TsunaHalo2001/RECUV/src/Conexiones/Conectores circulares RECUV 2/4 pines blank.jpg

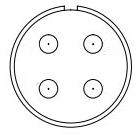
src/Conexiones/Conectores circulares RECUV 2/4 pines blank.jpg
