TsunaHalo2001/RECUV/RECUV PCB/REV 0.1/RECUV01/Schematic.pdf

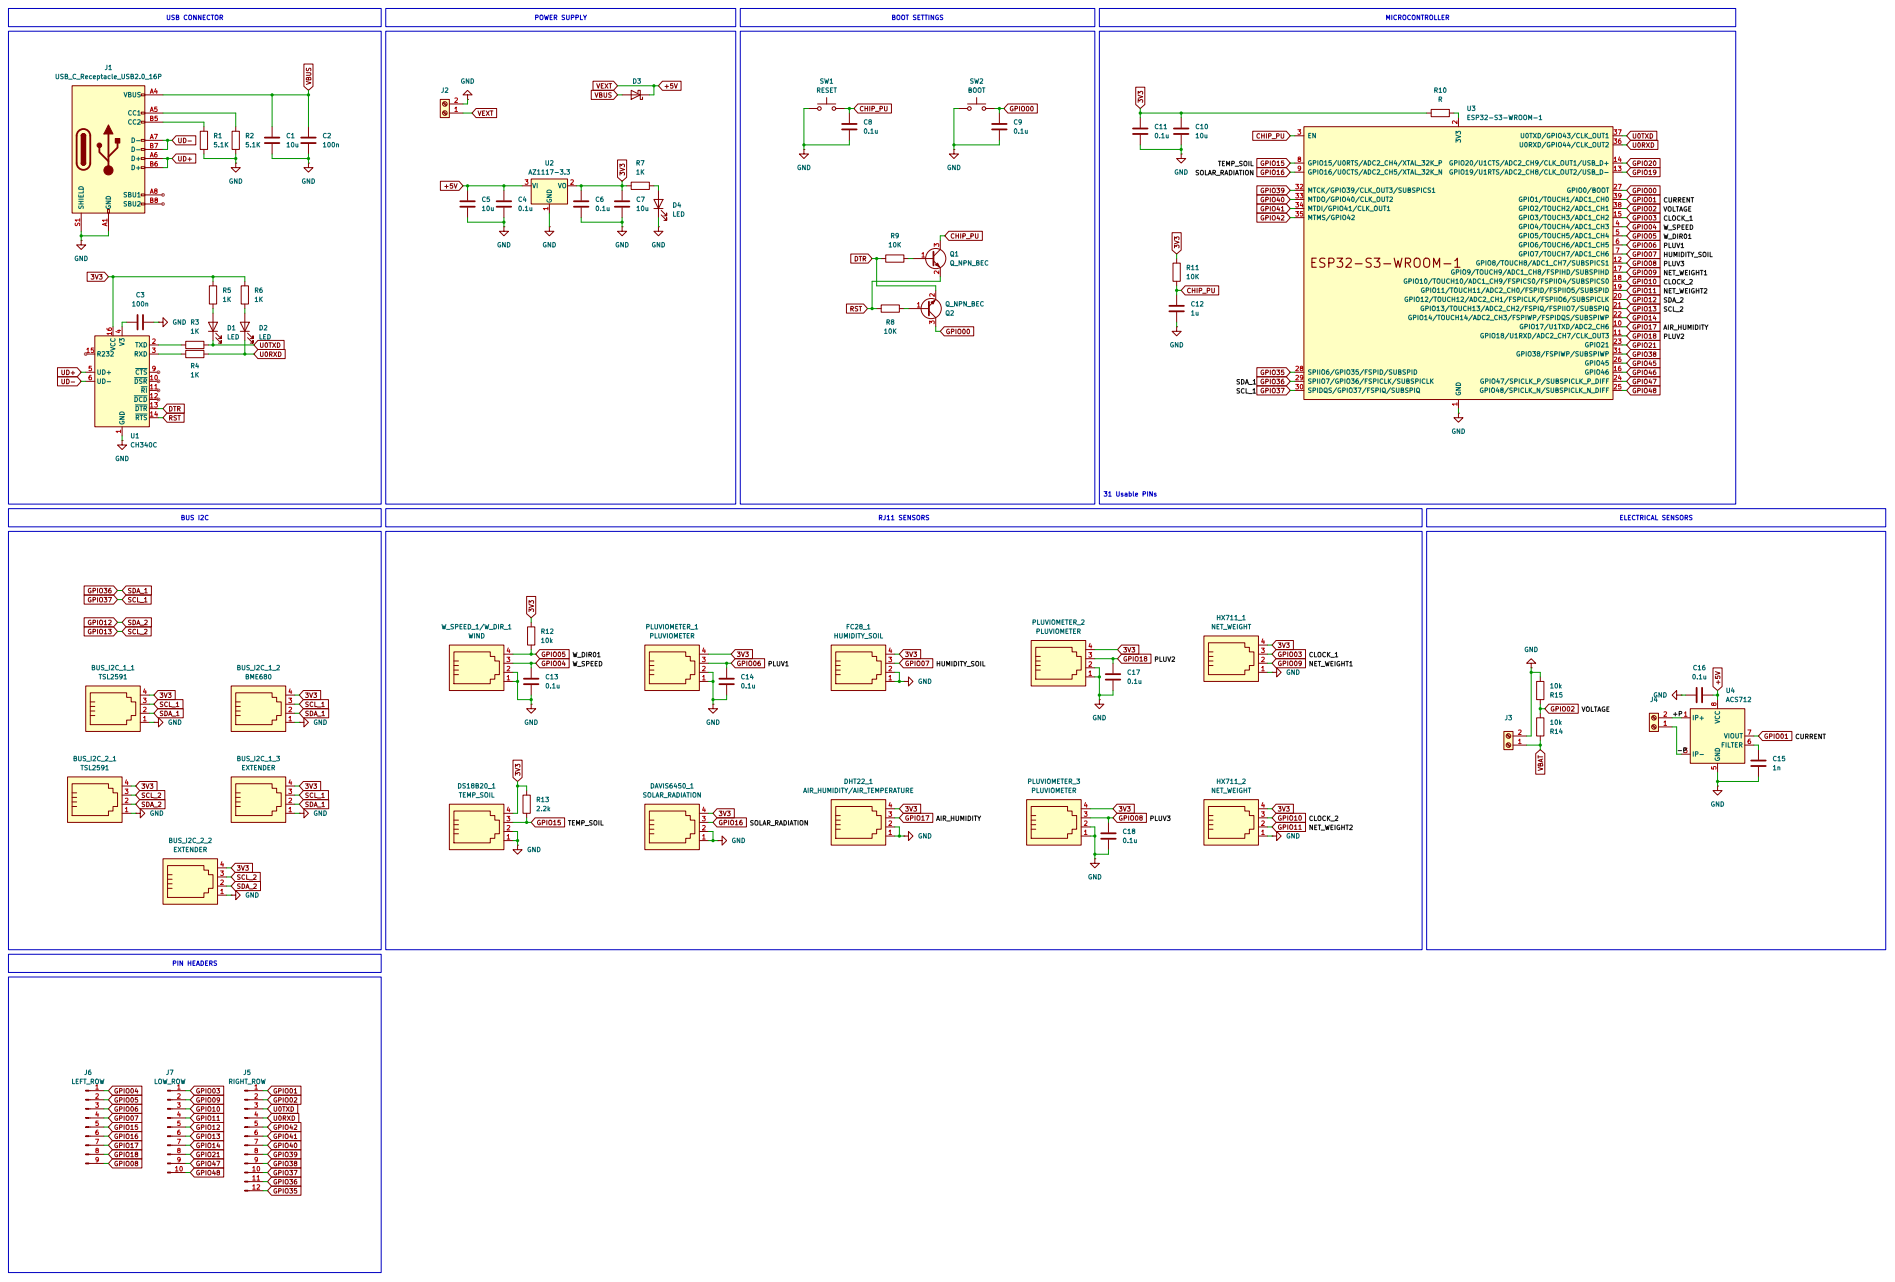
[picture p4: page 1]
