TsunaHalo2001/RECUV/RECUV PCB/REV 0.1/RECUV02_old/RECUV02.kicad_pcb

## KiCad design RECUV PCB/REV 0.1/RECUV02_old/RECUV02.kicad_pcb (2026-07-24, an earlier design)

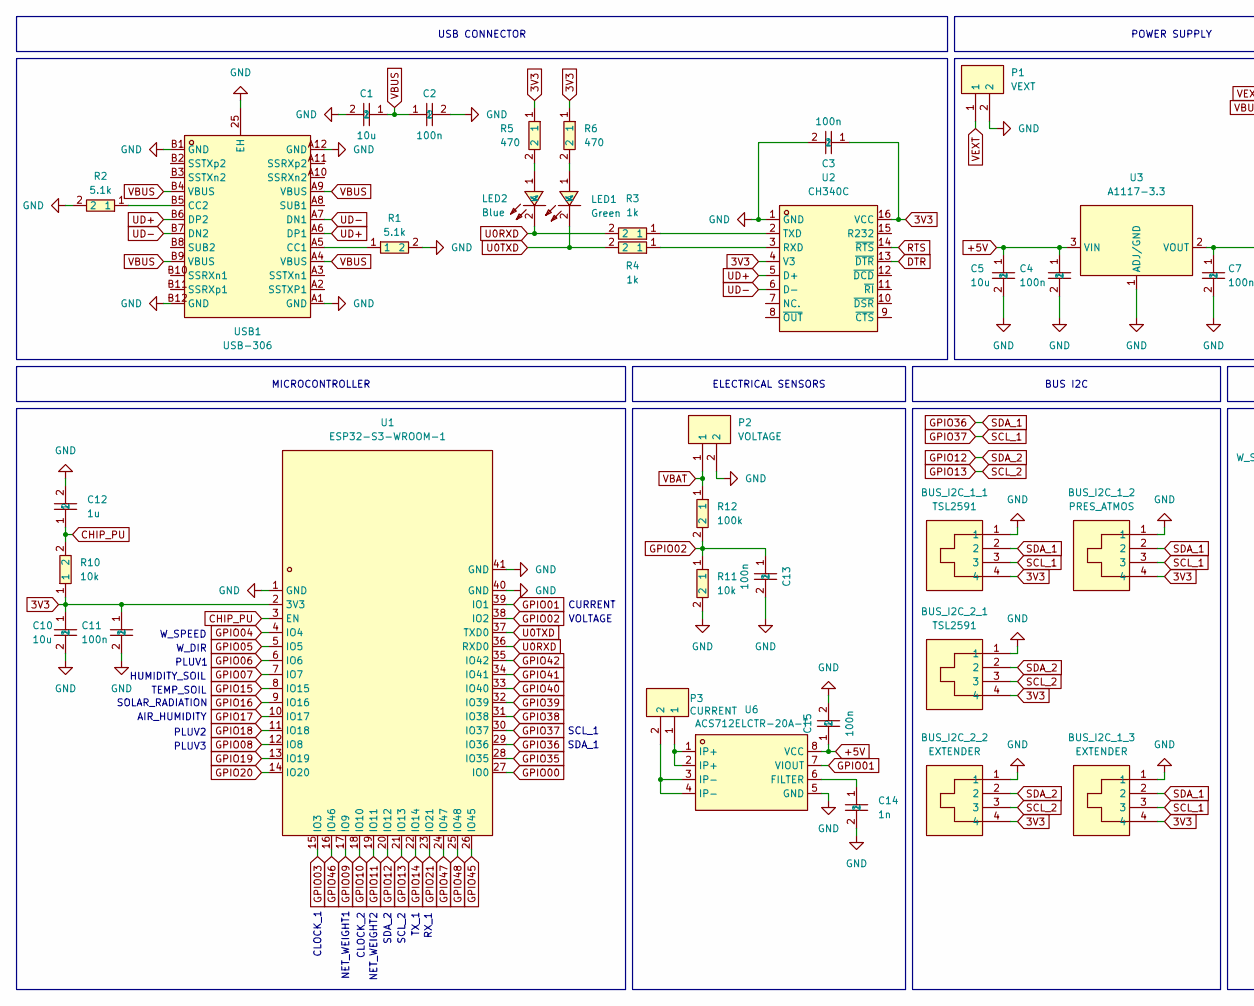
[picture p5: schematic RECUV02.kicad_sch, part in row 1, column 1]

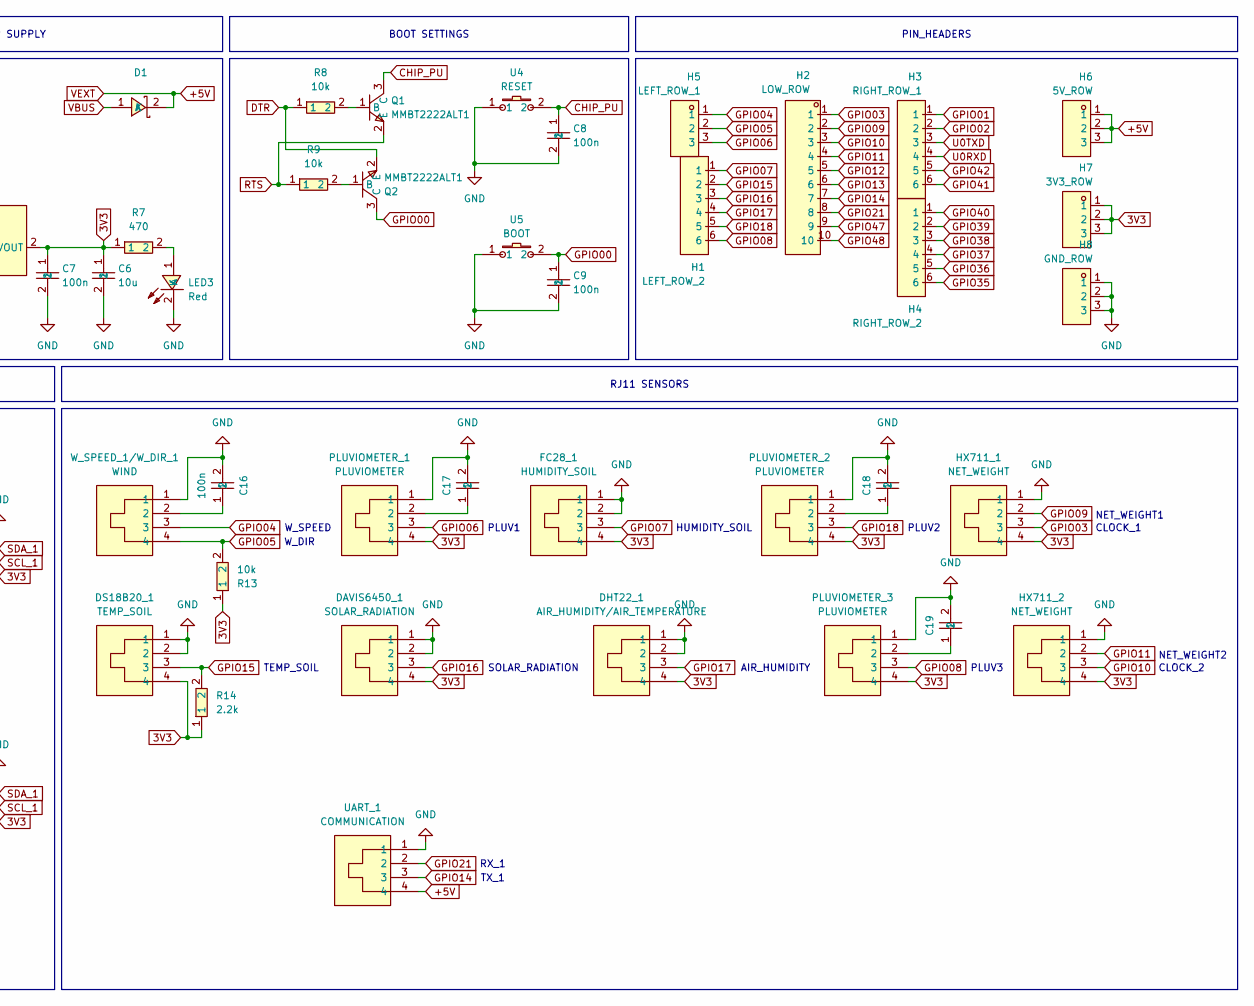
[picture p6: schematic RECUV02.kicad_sch, part in row 1, column 2]

Parts:
BUS_I2C_1_1, BUS_I2C_2_1: TSL2591; RJ11-TH_PCB-6P4C-90; MPN R-RJ11R04P-A800; LCSC Part C189749
BUS_I2C_1_2: PRES_ATMOS; RJ11-TH_PCB-6P4C-90; MPN R-RJ11R04P-A800; LCSC Part C189749
BUS_I2C_1_3, BUS_I2C_2_2: EXTENDER; RJ11-TH_PCB-6P4C-90; MPN R-RJ11R04P-A800; LCSC Part C189749
C1, C5, C6, C10: 10u; C0805; MPN CL21A106KOQNNNE; LCSC Part C1713
C2, C3, C4, C7, C8, C9, C11, C13, C15, C16, C17, C18, C19: 100n; C0805; MPN CL21B104KBCNNNC; LCSC Part C1711
C12: 1u; C0805; MPN CL21B105KAFNFNE; LCSC Part C1712
C14: 1n; C0805; MPN CL21C102JBCNNNC; LCSC Part C1791
D1: SS54_C22452; SMA_L4.4-W2.8-LS5.4-R-RD; MPN SS54; LCSC Part C22452
DAVIS6450_1: SOLAR_RADIATION; RJ11-TH_PCB-6P4C-90; MPN R-RJ11R04P-A800; LCSC Part C189749
DHT22_1: AIR_HUMIDITY/AIR_TEMPERATURE; RJ11-TH_PCB-6P4C-90; MPN R-RJ11R04P-A800; LCSC Part C189749
DS18B20_1: TEMP_SOIL; RJ11-TH_PCB-6P4C-90; MPN R-RJ11R04P-A800; LCSC Part C189749
FC28_1: HUMIDITY_SOIL; RJ11-TH_PCB-6P4C-90; MPN R-RJ11R04P-A800; LCSC Part C189749
H1: LEFT_ROW_2; HDR-TH_6P-P2.54-V-M-1; MPN 2.54-1x6P直针; LCSC Part C37208
H2: LOW_ROW; HDR-TH_10P-P2.54-V-M-1; MPN 2.54-1*10P针; LCSC Part C57369
H3: RIGHT_ROW_1; HDR-TH_6P-P2.54-V-M-1; MPN 2.54-1x6P直针; LCSC Part C37208
H4: RIGHT_ROW_2; HDR-TH_6P-P2.54-V-M-1; MPN 2.54-1x6P直针; LCSC Part C37208
H5: LEFT_ROW_1; HDR-TH_3P-P2.54-V-M; MPN A2541WV-3P; LCSC Part C5445396
H6: 5V_ROW; HDR-TH_3P-P2.54-V-M; MPN A2541WV-3P; LCSC Part C5445396
H7: 3V3_ROW; HDR-TH_3P-P2.54-V-M; MPN A2541WV-3P; LCSC Part C5445396
H8: GND_ROW; HDR-TH_3P-P2.54-V-M; MPN A2541WV-3P; LCSC Part C5445396
HX711_1, HX711_2: NET_WEIGHT; RJ11-TH_PCB-6P4C-90; MPN R-RJ11R04P-A800; LCSC Part C189749
LED1: Green; LED0805-R-RD; MPN KT-0805G; LCSC Part C2297
LED2: Blue; LED0805-R-RD; MPN KT-0805B; LCSC Part C2293
LED3: Red; LED0805-R-RD; MPN KT-0805R; LCSC Part C2295
P1: VEXT; CONN-TH_2P-P5.00_CPC3703CTR; MPN WJ127-5.0-02P-14-00A; LCSC Part C3703
P2: VOLTAGE; CONN-TH_2P-P5.00_CPC3703CTR; MPN WJ127-5.0-02P-14-00A; LCSC Part C3703
P3: CURRENT; CONN-TH_2P-P5.00_CPC3703CTR; MPN WJ127-5.0-02P-14-00A; LCSC Part C3703
PLUVIOMETER_1, PLUVIOMETER_2, PLUVIOMETER_3: PLUVIOMETER; RJ11-TH_PCB-6P4C-90; MPN R-RJ11R04P-A800; LCSC Part C189749
Q1, Q2: MMBT2222ALT1; SOT-23-3_L3.0-W1.7-P0.95-LS2.9-BR; MPN MMBT2222ALT1; LCSC Part C402270
R1, R2: 5.1k; R0805; MPN 0805W8J0512T5E; LCSC Part C26023
R3, R4: 1k; R0805; MPN 0805W8F1001T5E; LCSC Part C17513
R5, R6, R7: 470; R0805; MPN 0805W8F4700T5E; LCSC Part C17710
R8, R9, R10, R11, R13: 10k; R0805; MPN 0805W8F1002T5E; LCSC Part C17414
R12: 100k; R0805; MPN 0805W8J0104T5E; LCSC Part C25611
R14: 2.2k; R0603; MPN 0603WAF2201T5E; LCSC Part C4190
U1: ESP32-S3-WROOM-1; WIRELM-SMD_ESP32-S3-WROOM-1; MPN ESP32-S3-WROOM-1-N16R8; LCSC Part C2913202
U2: CH340C; SOP-16_L10.0-W3.9-P1.27-LS6.0-BL; MPN CH340C; LCSC Part C84681
U3: A1117-3.3; SOT-223-3_L6.5-W3.4-P2.30-LS7.0-BR-1; MPN A1117-3.3; LCSC Part C7432020
U4: RESET; SW-SMD_KSR213GLFG; MPN KSR213GLFG; LCSC Part C668561
U5: BOOT; SW-SMD_KSR213GLFG; MPN KSR213GLFG; LCSC Part C668561
U6: ACS712ELCTR-20A-T; SOIC-8_L4.9-W3.9-P1.27-LS6.0-BL; MPN ACS712ELCTR-20A-T; LCSC Part C10681
UART_1: COMMUNICATION; RJ11-TH_PCB-6P4C-90; MPN R-RJ11R04P-A800; LCSC Part C189749
USB1: USB-306; USB-TYPE-C-TH_USB-306-1; MPN USB-306-B-SU; LCSC Part C309338
W_SPEED_1/W_DIR_1: WIND; RJ11-TH_PCB-6P4C-90; MPN R-RJ11R04P-A800; LCSC Part C189749

Connections:
3V3: BUS_I2C_1_1.4, BUS_I2C_1_2.4, BUS_I2C_1_3.4, BUS_I2C_2_1.4, BUS_I2C_2_2.4, C3.1, C6.1, C7.1, C10.1, C11.1, DAVIS6450_1.4, DHT22_1.4, DS18B20_1.4, FC28_1.4, H7.1, H7.2, H7.3, HX711_1.4, HX711_2.4, PLUVIOMETER_1.4, PLUVIOMETER_2.4, PLUVIOMETER_3.4, R5.1, R6.1, R7.1, R10.1, R13.1, R14.1, U1.2 (3V3), U2.4 (V3), U2.16 (VCC), U3.2 (VOUT)
+5V: C4.1, C5.1, C15.1, D1.2 (K), H6.1, H6.2, H6.3, P1.1, U3.3 (VIN), U6.8 (VCC), UART_1.4
CHIP_PU: C8.1, C12.1, Q1.3 (C), R10.2, U1.3 (EN), U4.2
DTR: Q2.2 (E), R8.1, U2.13 (~DTR)
GND: BUS_I2C_1_1.1, BUS_I2C_1_2.1, BUS_I2C_1_3.1, BUS_I2C_2_1.1, BUS_I2C_2_2.1, C1.2, C2.2, C3.2, C4.2, C5.2, C6.2, C7.2, C8.2, C9.2, C10.2, C11.2, C12.2, C13.2, C14.2, C15.2, C16.2, C17.2, C18.2, C19.2, DAVIS6450_1.1, DAVIS6450_1.2, DHT22_1.1, DHT22_1.2, DS18B20_1.1, DS18B20_1.2, FC28_1.1, FC28_1.2, H8.1, H8.2, H8.3, HX711_1.1, HX711_2.1, LED3.2 (K), P1.2, P2.2, PLUVIOMETER_1.1, PLUVIOMETER_2.1, PLUVIOMETER_3.1, R1.2, R2.2, R11.2, U1.1 (GND), U1.40 (GND), U1.41 (GND), U2.1 (GND), U3.1 (ADJ/GND), U4.1, U5.1, U6.5 (GND), UART_1.1, USB1.25 (EH), USB1.A1 (GND), USB1.A12 (GND), USB1.B1 (GND), USB1.B12 (GND), W_SPEED_1/W_DIR_1.1
GPIO00: C9.1, Q2.3 (C), U1.27 (IO0), U5.2
GPIO01: H3.1, U1.39 (IO1), U6.7 (VIOUT)
GPIO02: C13.1, H3.2, R11.1, R12.2, U1.38 (IO2)
GPIO03: H2.1, HX711_1.3, U1.15 (IO3)
GPIO04: H5.1, U1.4 (IO4), W_SPEED_1/W_DIR_1.3
GPIO05: H5.2, R13.2, U1.5 (IO5), W_SPEED_1/W_DIR_1.4
GPIO06: H5.3, PLUVIOMETER_1.3, U1.6 (IO6)
GPIO07: FC28_1.3, H1.1, U1.7 (IO7)
GPIO08: H1.6, PLUVIOMETER_3.3, U1.12 (IO8)
GPIO09: H2.2, HX711_1.2, U1.17 (IO9)
GPIO10: H2.3, HX711_2.3, U1.18 (IO10)
GPIO11: H2.4, HX711_2.2, U1.19 (IO11)
GPIO12: BUS_I2C_2_1.2, BUS_I2C_2_2.2, H2.5, U1.20 (IO12)
GPIO13: BUS_I2C_2_1.3, BUS_I2C_2_2.3, H2.6, U1.21 (IO13)
GPIO14: H2.7, U1.22 (IO14), UART_1.3
GPIO15: DS18B20_1.3, H1.2, R14.2, U1.8 (IO15)
GPIO16: DAVIS6450_1.3, H1.3, U1.9 (IO16)
GPIO17: DHT22_1.3, H1.4, U1.10 (IO17)
GPIO18: H1.5, PLUVIOMETER_2.3, U1.11 (IO18)
GPIO19: U1.13 (IO19)
GPIO20: U1.14 (IO20)
GPIO21: H2.8, U1.23 (IO21), UART_1.2
GPIO35: H4.6, U1.28 (IO35)
GPIO36: BUS_I2C_1_1.2, BUS_I2C_1_2.2, BUS_I2C_1_3.2, H4.5, U1.29 (IO36)
GPIO37: BUS_I2C_1_1.3, BUS_I2C_1_2.3, BUS_I2C_1_3.3, H4.4, U1.30 (IO37)
GPIO38: H4.3, U1.31 (IO38)
GPIO39: H4.2, U1.32 (IO39)
GPIO40: H4.1, U1.33 (IO40)
GPIO41: H3.6, U1.34 (IO41)
GPIO42: H3.5, U1.35 (IO42)
GPIO45: U1.26 (IO45)
GPIO46: U1.16 (IO46)
GPIO47: H2.9, U1.24 (IO47)
GPIO48: H2.10, U1.25 (IO48)
unnamed: C16.1, W_SPEED_1/W_DIR_1.2
unnamed: C17.1, PLUVIOMETER_1.2
unnamed: C18.1, PLUVIOMETER_2.2
unnamed: C19.1, PLUVIOMETER_3.2
unnamed: LED1.1 (A), R6.2
unnamed: LED2.1 (A), R5.2
unnamed: LED3.1 (A), R7.2
unnamed: P3.1, U6.1 (IP+), U6.2 (IP+)
unnamed: P3.2, U6.3 (IP-), U6.4 (IP-)
unnamed: Q1.1 (B), R8.2
unnamed: Q2.1 (B), R9.2
unnamed: R4.1, U2.3 (RXD)
unnamed: R3.1, U2.2 (TXD)
unnamed: C14.1, U6.6 (FILTER)
unnamed: R1.1, USB1.A5 (CC1)
unnamed: R2.1, USB1.B5 (CC2)
RTS: Q1.2 (E), R9.1, U2.14 (~RTS)
U0RXD: H3.4, LED2.2 (K), R3.2, U1.36 (RXD0)
U0TXD: H3.3, LED1.2 (K), R4.2, U1.37 (TXD0)
UD+: U2.5 (D+), USB1.A6 (DP1), USB1.B6 (DP2)
UD-: U2.6 (D-), USB1.A7 (DN1), USB1.B7 (DN2)
VBAT: P2.1, R12.1
VBUS: C1.1, C2.1, D1.1 (A), USB1.A4 (VBUS), USB1.A9 (VBUS), USB1.B4 (VBUS), USB1.B9 (VBUS)

Notes on the sheet:
PLUV1
RX_1
HUMIDITY_SOIL
CURRENT
CLOCK_2
TX_1
SCL_1
W_SPEED
NET_WEIGHT2
NET_WEIGHT1
CLOCK_1
SDA_1
W_DIR
PLUV2
VOLTAGE
SOLAR_RADIATION
TEMP_SOIL
PLUV3
AIR_HUMIDITY
SCL_2
SDA_2
PIN_HEADERS
USB CONNECTOR
MICROCONTROLLER
RJ11 SENSORS
POWER SUPPLY
BUS I2C
BOOT SETTINGS
ELECTRICAL SENSORS

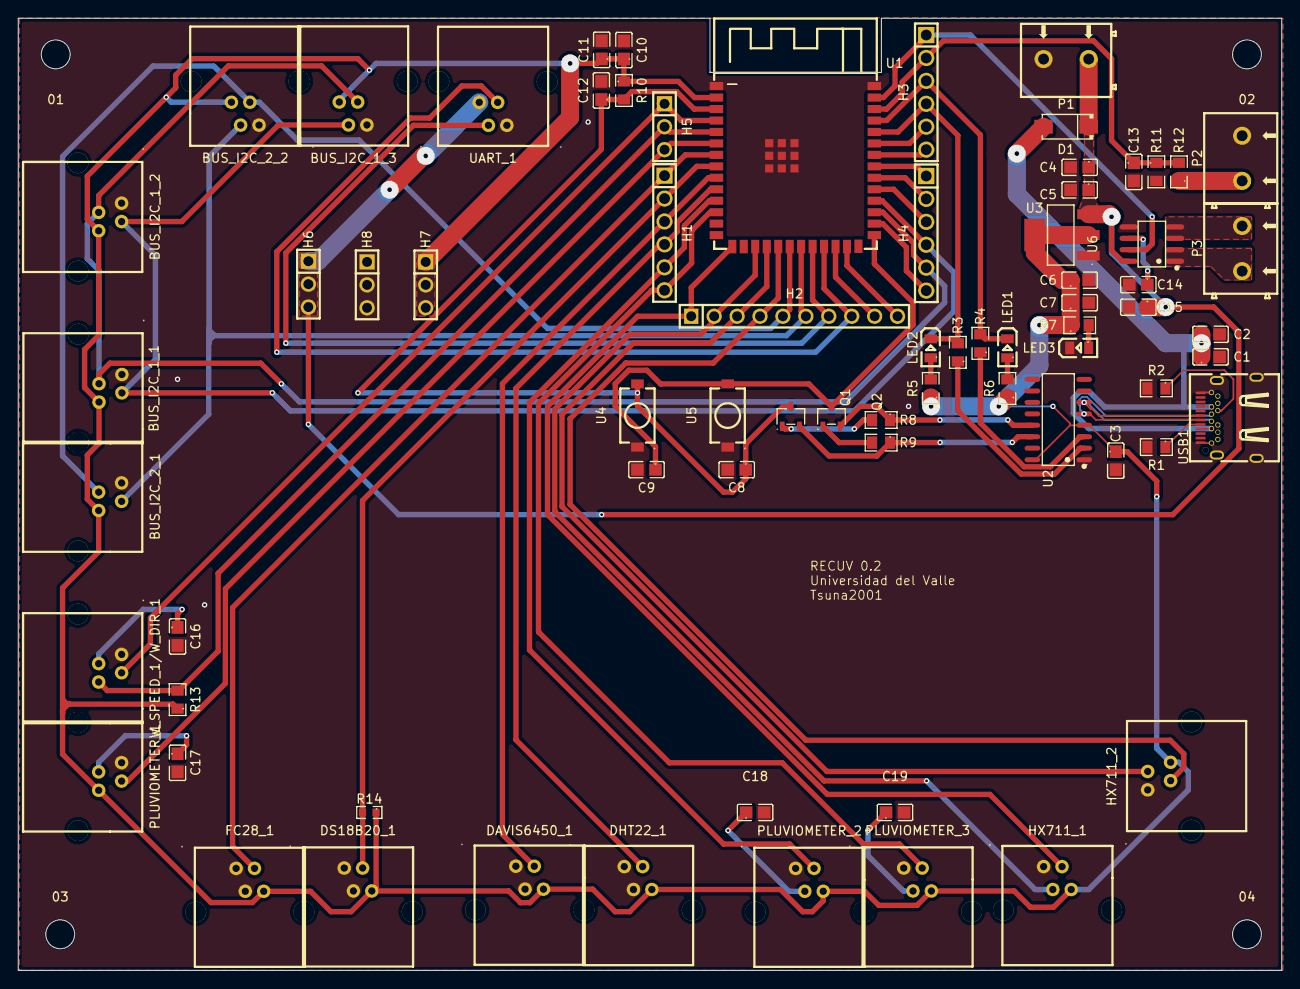
[picture p7: board RECUV02.kicad_pcb from above]

Board: 2 copper layers, 140.0 x 105.5 mm, 77 parts (0 on the bottom side), 58 nets.

Other parts of the board:
01, 02, 03, 04: MountingHole_3.2mm_M3
