TsunaHalo2001/RECUV/RECUV PCB/REV 0.1/RECUV01/RECUV01.kicad_pcb

## KiCad design RECUV PCB/REV 0.1/RECUV01/RECUV01.kicad_pcb (2025-07-10)

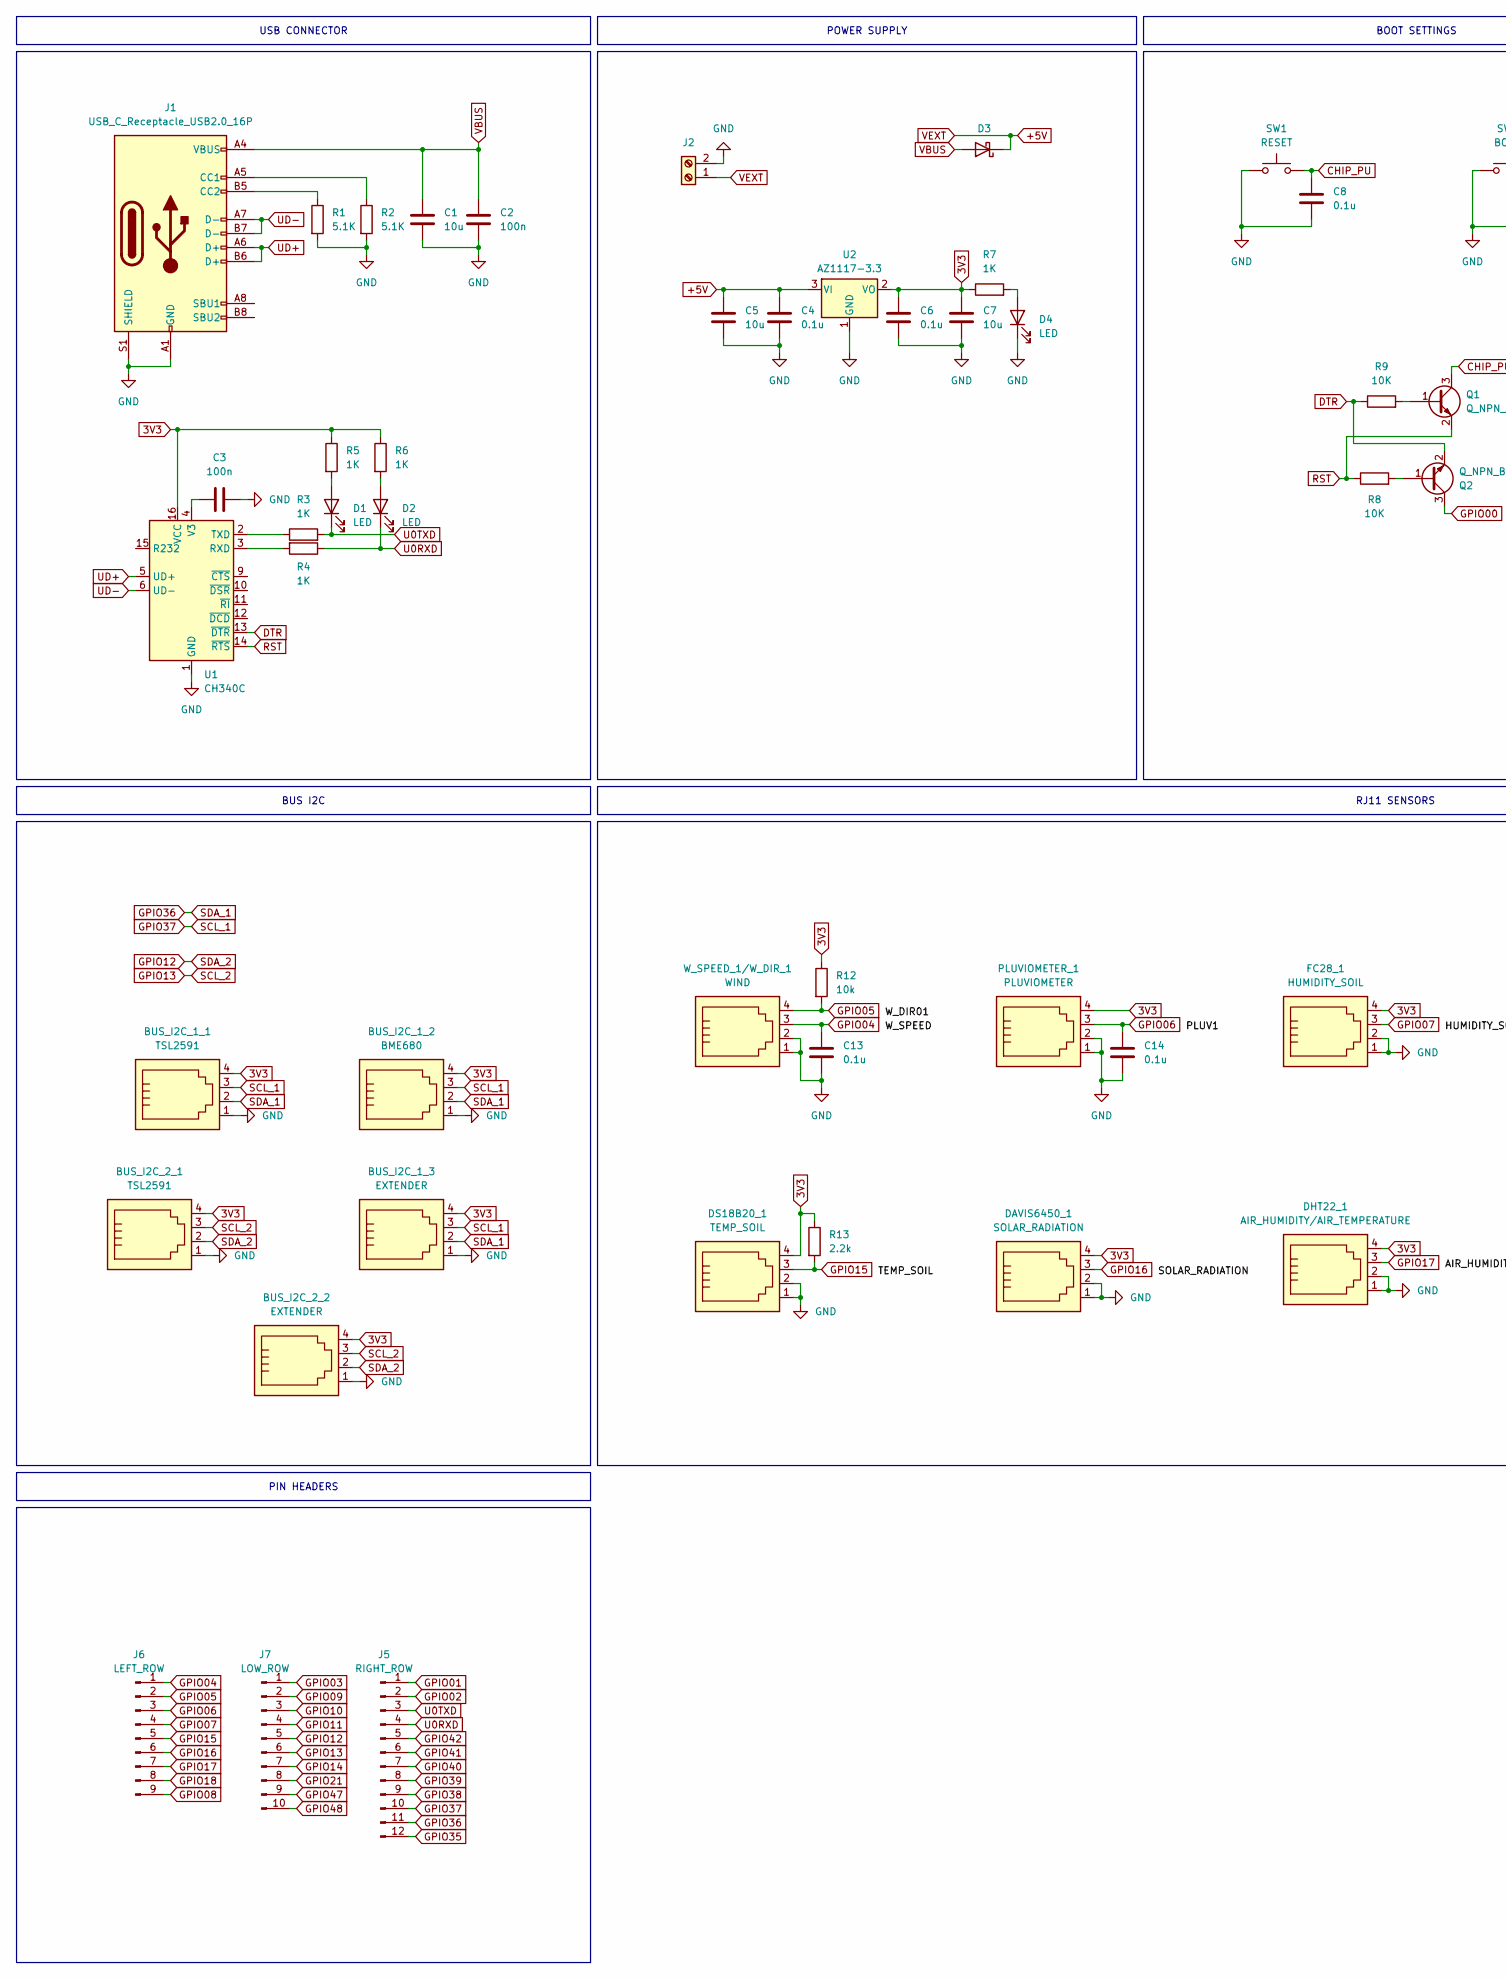
[picture p8: schematic RECUV01.kicad_sch, part in row 1, column 1]

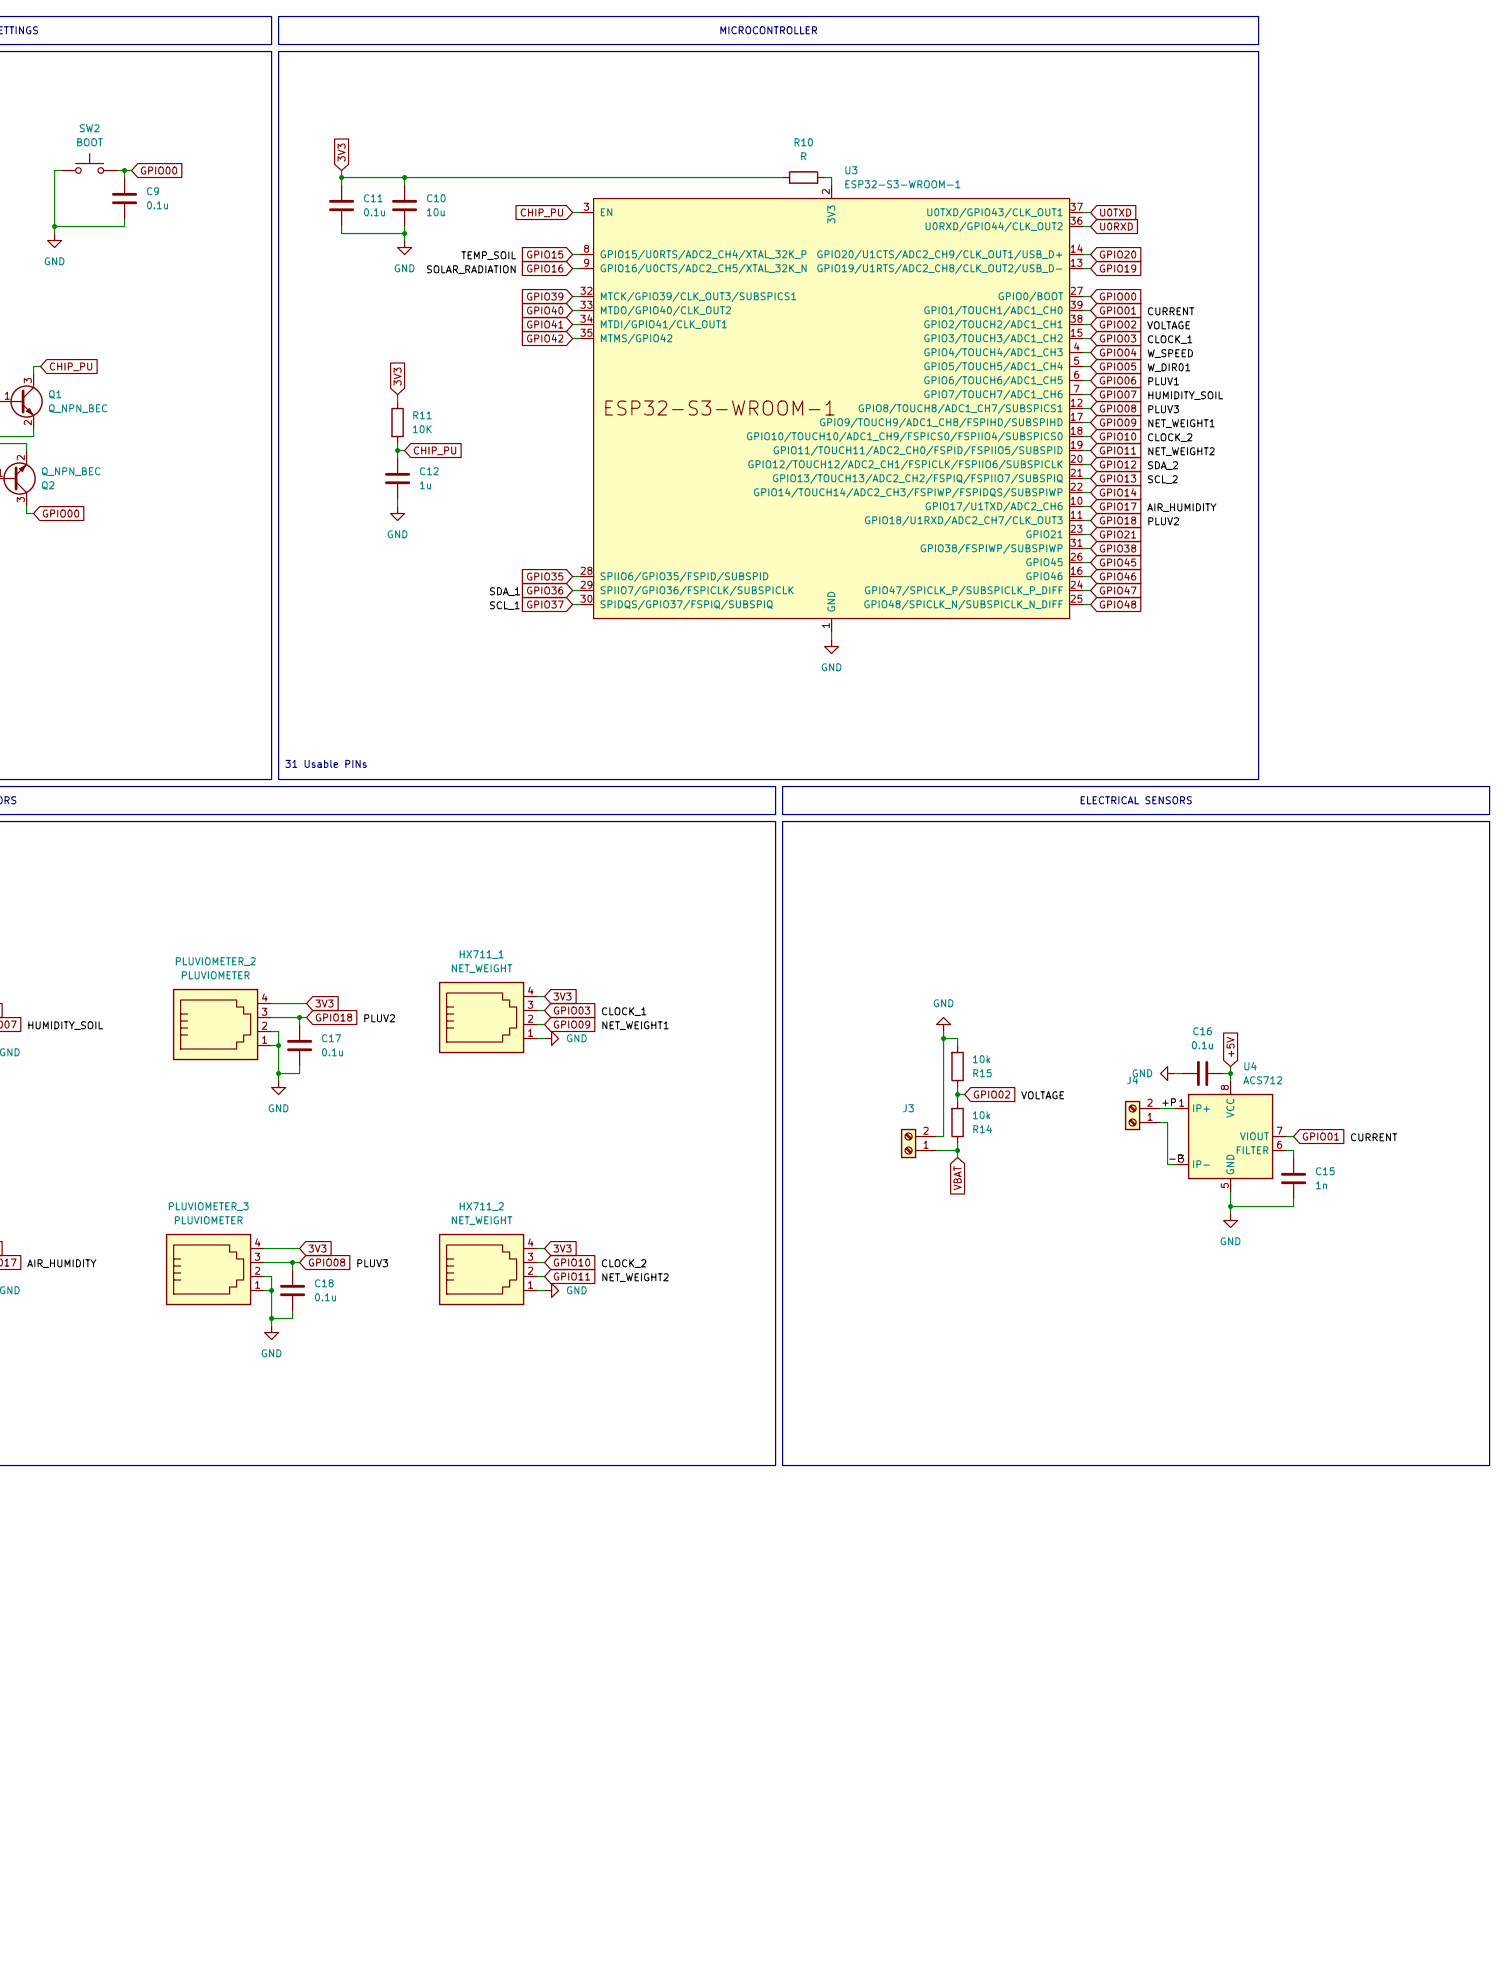
[picture p9: schematic RECUV01.kicad_sch, part in row 1, column 2]

Parts:
BUS_I2C_1_1, BUS_I2C_2_1: TSL2591; RJ9_Evercom_5301-440xxx_Horizontal
BUS_I2C_1_2: BME680; RJ9_Evercom_5301-440xxx_Horizontal
BUS_I2C_1_3, BUS_I2C_2_2: EXTENDER; RJ9_Evercom_5301-440xxx_Horizontal
C1, C5, C7, C10: 10u; C_0805_2012Metric
C2, C3: 100n; C_0805_2012Metric
C4, C6, C8, C9, C11, C13, C14, C16, C17, C18: 0.1u; C_0805_2012Metric
C12: 1u; C_0805_2012Metric
C15: 1n; C_0805_2012Metric
D1, D2, D4: LED; LED_0805_2012Metric
D3: D_Schottky; D_SMA
DAVIS6450_1: SOLAR_RADIATION; RJ9_Evercom_5301-440xxx_Horizontal
DHT22_1: AIR_HUMIDITY/AIR_TEMPERATURE; RJ9_Evercom_5301-440xxx_Horizontal
DS18B20_1: TEMP_SOIL; RJ9_Evercom_5301-440xxx_Horizontal
FC28_1: HUMIDITY_SOIL; RJ9_Evercom_5301-440xxx_Horizontal
HX711_1, HX711_2: NET_WEIGHT; RJ9_Evercom_5301-440xxx_Horizontal
J1: USB_C_Receptacle_USB2.0_16P; USB_C_Receptacle_XKB_U262-16XN-4BVC11
J2: Screw_Terminal_01x02; TerminalBlock_Altech_AK300-2_P5.00mm
J3, J4: TerminalBlock_Altech_AK300-2_P5.00mm
J5: RIGHT_ROW; PinHeader_1x12_P2.54mm_Vertical
J6: LEFT_ROW; PinHeader_1x09_P2.54mm_Vertical
J7: LOW_ROW; PinHeader_1x10_P2.54mm_Vertical
PLUVIOMETER_1, PLUVIOMETER_2, PLUVIOMETER_3: PLUVIOMETER; RJ9_Evercom_5301-440xxx_Horizontal
Q1, Q2: Q_NPN_BEC; SOT-23-3
R1, R2: 5.1K; R_0805_2012Metric
R3, R4, R5, R6, R7: 1K; R_0805_2012Metric
R8, R9, R11: 10K; R_0805_2012Metric
R10: R; R_0805_2012Metric
R12, R14, R15: 10k; R_0805_2012Metric
R13: 2.2k; R_0805_2012Metric
SW1: RESET; SW_Tactile_SPST_NO_Straight_CK_PTS636Sx25SMTRLFS
SW2: BOOT; SW_Tactile_SPST_NO_Straight_CK_PTS636Sx25SMTRLFS
U1: CH340C; SOIC-16_3.9x9.9mm_P1.27mm
U2: AZ1117-3.3; SOT-223-3_TabPin2
U3: ESP32-S3-WROOM-1
U4: ACS712; SOIC-8_3.9x4.9mm_P1.27mm
W_SPEED_1/W_DIR_1: WIND; RJ9_Evercom_5301-440xxx_Horizontal

Connections:
3V3: BUS_I2C_1_1.4, BUS_I2C_1_2.4, BUS_I2C_1_3.4, BUS_I2C_2_1.4, BUS_I2C_2_2.4, C6.1, C7.1, C10.1, C11.1, DAVIS6450_1.4, DHT22_1.4, DS18B20_1.4, FC28_1.4, HX711_1.4, HX711_2.4, PLUVIOMETER_1.4, PLUVIOMETER_2.4, PLUVIOMETER_3.4, R5.1, R6.1, R7.1, R10.1, R11.1, R12.1, R13.1, U1.16 (VCC), U2.2 (VO)
+5V: C4.1, C5.1, C16.2, D3.1 (K), J2.1, U2.3 (VI), U4.8 (VCC)
/+P: J4.2, U4.1 (IP+), U4.2 (IP+)
/-P: J4.1, U4.3 (IP-), U4.4 (IP-)
CHIP_PU: C8.1, C12.1, Q1.3 (C), R11.2, SW1.2, U3.3 (EN)
DTR: Q2.2 (E), R9.1, U1.13 (~DTR)
GND: BUS_I2C_1_1.1, BUS_I2C_1_2.1, BUS_I2C_1_3.1, BUS_I2C_2_1.1, BUS_I2C_2_2.1, C1.2, C2.2, C3.2, C4.2, C5.2, C6.2, C7.2, C8.2, C9.2, C10.2, C11.2, C12.2, C13.2, C14.2, C15.2, C16.1, C17.2, C18.2, D4.1 (K), DAVIS6450_1.1, DAVIS6450_1.2, DHT22_1.1, DHT22_1.2, DS18B20_1.1, DS18B20_1.2, FC28_1.1, FC28_1.2, HX711_1.1, HX711_2.1, J1.A1 (GND), J1.A12 (GND), J1.B1 (GND), J1.B12 (GND), J1.S1 (SHIELD), J2.2, J3.2, PLUVIOMETER_1.1, PLUVIOMETER_1.2, PLUVIOMETER_2.1, PLUVIOMETER_2.2, PLUVIOMETER_3.1, PLUVIOMETER_3.2, R1.2, R2.2, R15.2, SW1.1, SW2.1, U1.1 (GND), U2.1 (GND), U3.1 (GND), U3.40 (GND), U3.41 (GND), U4.5 (GND), W_SPEED_1/W_DIR_1.1, W_SPEED_1/W_DIR_1.2
GPIO00: C9.1, Q2.3 (C), SW2.2, U3.27 (GPIO0/BOOT)
GPIO01: J5.1, U3.39 (GPIO1/TOUCH1/ADC1_CH0), U4.7 (VIOUT)
GPIO02: J5.2, R14.2, R15.1, U3.38 (GPIO2/TOUCH2/ADC1_CH1)
GPIO03: HX711_1.3, J7.1, U3.15 (GPIO3/TOUCH3/ADC1_CH2)
GPIO04: C13.1, J6.1, U3.4 (GPIO4/TOUCH4/ADC1_CH3), W_SPEED_1/W_DIR_1.3
GPIO05: J6.2, R12.2, U3.5 (GPIO5/TOUCH5/ADC1_CH4), W_SPEED_1/W_DIR_1.4
GPIO06: C14.1, J6.3, PLUVIOMETER_1.3, U3.6 (GPIO6/TOUCH6/ADC1_CH5)
GPIO07: FC28_1.3, J6.4, U3.7 (GPIO7/TOUCH7/ADC1_CH6)
GPIO08: C18.1, J6.9, PLUVIOMETER_3.3, U3.12 (GPIO8/TOUCH8/ADC1_CH7/SUBSPICS1)
GPIO09: HX711_1.2, J7.2, U3.17 (GPIO9/TOUCH9/ADC1_CH8/FSPIHD/SUBSPIHD)
GPIO10: HX711_2.3, J7.3, U3.18 (GPIO10/TOUCH10/ADC1_CH9/FSPICS0/FSPIIO4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)
GPIO11: HX711_2.2, J7.4, U3.19 (GPIO11/TOUCH11/ADC2_CH0/FSPID/FSPIIO5/S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)
GPIO12: BUS_I2C_2_1.2, BUS_I2C_2_2.2, J7.5, U3.20 (GPIO12/TOUCH12/ADC2_CH1/FSPICLK/FSPIIO6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)
GPIO13: BUS_I2C_2_1.3, BUS_I2C_2_2.3, J7.6, U3.21 (GPIO13/TOUCH13/ADC2_CH2/FSPIQ/FSPIIO7/S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)
GPIO14: J7.7, U3.22 (GPIO14/TOUCH14/ADC2_CH3/FSPIWP/FSPIDQS/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)
GPIO15: DS18B20_1.3, J6.5, R13.2, U3.8 (GPIO15/U0RTS/ADC2_CH4/XTAL_32K_P)
GPIO16: DAVIS6450_1.3, J6.6, U3.9 (GPIO16/U0CTS/ADC2_CH5/XTAL_32K_N)
GPIO17: DHT22_1.3, J6.7, U3.10 (GPIO17/U1TXD/ADC2_CH6)
GPIO18: C17.1, J6.8, PLUVIOMETER_2.3, U3.11 (GPIO18/U1RXD/ADC2_CH7/CLK_OUT3)
GPIO19: U3.13 (GPIO19/U1RTS/ADC2_CH8/CLK_OUT2/USB_D-)
GPIO20: U3.14 (GPIO20/U1CTS/ADC2_CH9/CLK_OUT1/USB_D+)
GPIO21: J7.8, U3.23 (GPIO21)
GPIO35: J5.12, U3.28 (SPIIO6/GPIO35/FSPID/SUBSPID)
GPIO36: BUS_I2C_1_1.2, BUS_I2C_1_2.2, BUS_I2C_1_3.2, J5.11, U3.29 (SPIIO7/GPIO36/FSPICLK/SUBSPICLK)
GPIO37: BUS_I2C_1_1.3, BUS_I2C_1_2.3, BUS_I2C_1_3.3, J5.10, U3.30 (SPIDQS/GPIO37/FSPIQ/SUBSPIQ)
GPIO38: J5.9, U3.31 (GPIO38/FSPIWP/SUBSPIWP)
GPIO39: J5.8, U3.32 (MTCK/GPIO39/CLK_OUT3/SUBSPICS1)
GPIO40: J5.7, U3.33 (MTDO/GPIO40/CLK_OUT2)
GPIO41: J5.6, U3.34 (MTDI/GPIO41/CLK_OUT1)
GPIO42: J5.5, U3.35 (MTMS/GPIO42)
GPIO45: U3.26 (GPIO45)
GPIO46: U3.16 (GPIO46)
GPIO47: J7.9, U3.24 (GPIO47/SPICLK_P/SUBSPICLK_P_DIFF)
GPIO48: J7.10, U3.25 (GPIO48/SPICLK_N/SUBSPICLK_N_DIFF)
unnamed: D1.2 (A), R5.2
unnamed: D2.2 (A), R6.2
unnamed: D4.2 (A), R7.2
unnamed: J1.A5 (CC1), R2.1
unnamed: J1.B5 (CC2), R1.1
unnamed: Q1.1 (B), R9.2
unnamed: Q2.1 (B), R8.2
unnamed: R4.2, U1.3 (RXD)
unnamed: R3.1, U1.2 (TXD)
unnamed: C3.1, U1.4 (V3)
unnamed: R10.2, U3.2 (3V3)
unnamed: C15.1, U4.6 (FILTER)
RST: Q1.2 (E), R8.1, U1.14 (~RTS)
U0RXD: D2.1 (K), J5.4, R4.1, U3.36 (U0RXD/GPIO44/CLK_OUT2)
U0TXD: D1.1 (K), J5.3, R3.2, U3.37 (U0TXD/GPIO43/CLK_OUT1)
UD+: J1.A6 (D+), J1.B6 (D+), U1.5 (UD+)
UD-: J1.A7 (D-), J1.B7 (D-), U1.6 (UD-)
VBAT: J3.1, R14.1
VBUS: C1.1, C2.1, D3.2 (A), J1.A4 (VBUS), J1.A9 (VBUS), J1.B4 (VBUS), J1.B9 (VBUS)

Notes on the sheet:
BOOT SETTINGS
USB CONNECTOR
RJ11 SENSORS
ELECTRICAL SENSORS
PIN HEADERS
BUS I2C
MICROCONTROLLER
POWER SUPPLY
31 Usable PINs

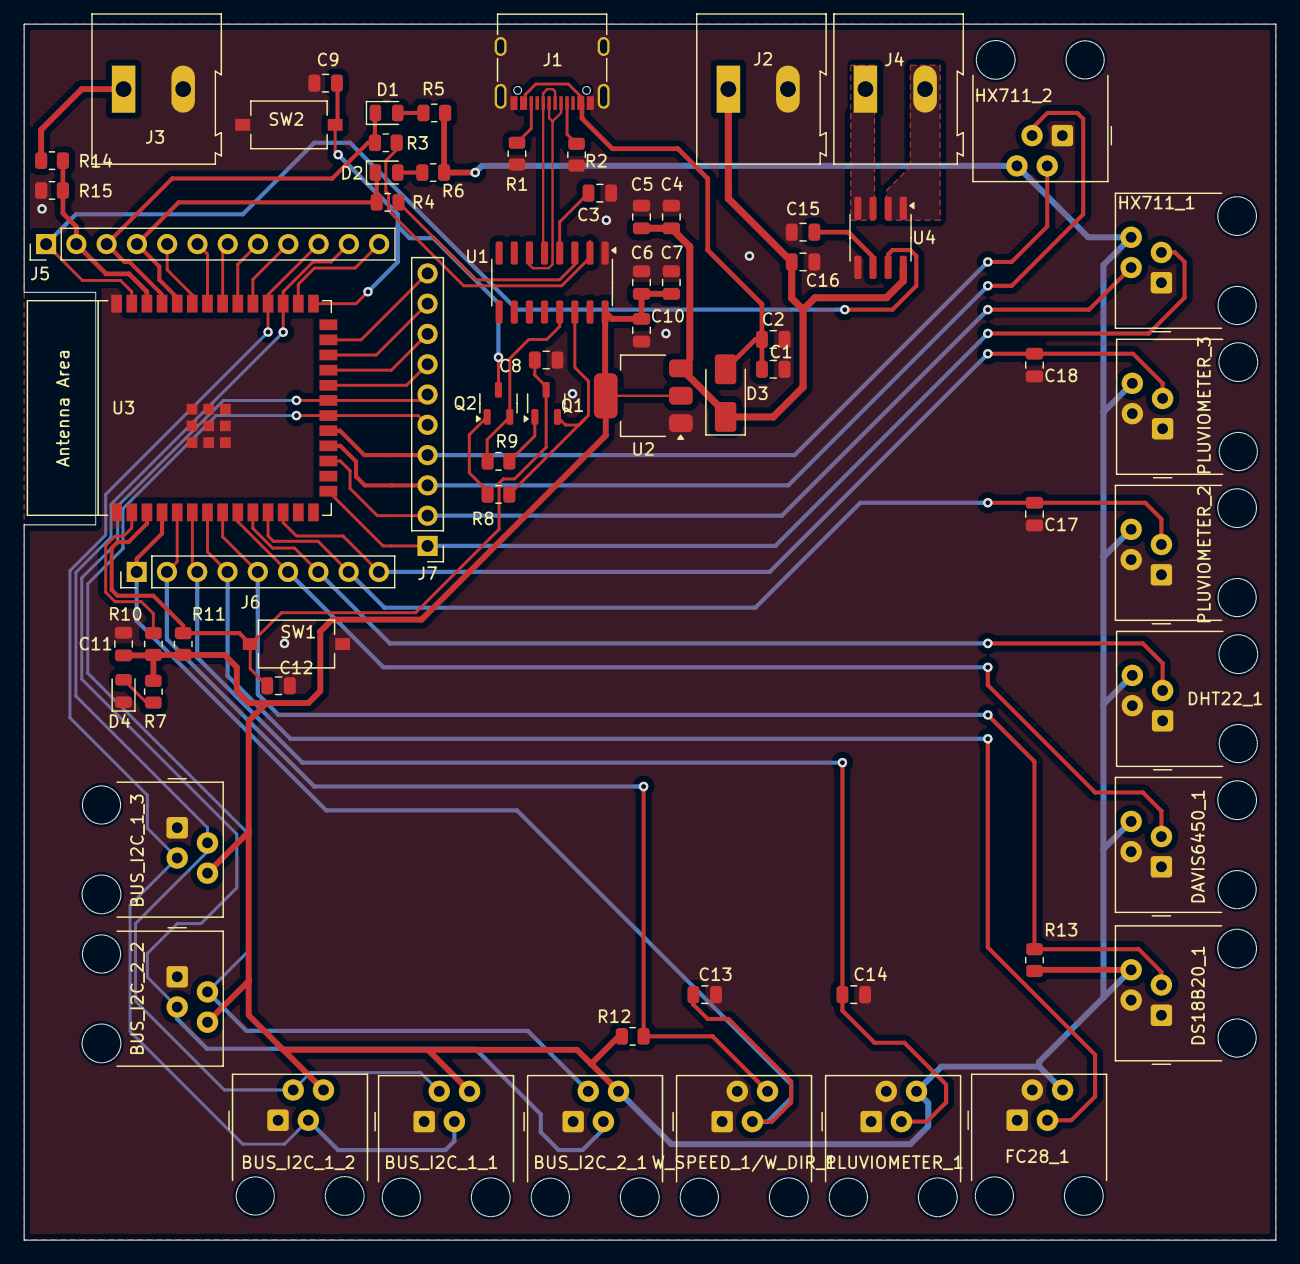
[picture p10: board RECUV01.kicad_pcb from above]

Board: 2 copper layers, 105.0 x 102.0 mm, 67 parts (0 on the bottom side), 56 nets.
