TsunaHalo2001/RECUV/RECUV 1/ESP32/main.py

# Escribe tu código aquí :-)
from system_communication import *
from machine import Pin, UART, SPI, reset, deepsleep, WDT
import json
from time import *
import network
import ntptime

wdt = WDT(timeout=60000)

import urequests as requests
import ujson

TIAMPO_SONDEO_CONST = 10*60   # CANT_MINUTOS  * 60 SEG

global CONNECTION_MODE, SSID, PASSWORD
global modemwifi


CONNECTION_MODE  = "WIFI"
#CONNECTION_MODE = "GPRS"

#SSID     = "univalle"
#PASSWORD = "Univalle"

SSID     = "GISMODEL"
PASSWORD = "GISMODEL2023"

ntptime.host = "pool.ntp.org"
ntptime.timeout = 5


global tramaRx, sensor_amb_values, gprs, modemwifi, bandera_muestreo
global textoCompuerta,textoLamina, textoMuestreo, textoHora, t_envio, contador_envio
global banderaConsumo, banderaNivel, banderaAmb
global consumoIF, nivelIF, ambIF
global tiempoSONDEOWEB
global trama



textoCompuerta =" "
textoLamina    =" "
textoMuestreo  =" "
textoHora      =" "


uart = UART(1, 9600)

#------------------------------------------------------------------#
#                        VARIABLES DE CONSUMO                      #
#------------------------------------------------------------------#

#CREAMOS UN DICCIONARIO DONDE GUARDAREMOS LAS VARIABLES DE CONSUMO

sensor_consumo_values={
"tiempo_ele":"2022-05-25 19:00:00",
"vdc_bat_comp1":"26.8",
"idc_bat_comp1":"5.5",
"cbat_comp1":"80",
"idc_siscomp1":"3.4",
"valcon_siscomp1":"52",
}


#------------------------------------------------------------------#
#                        VARIABLES DE NIVEL                        #
#------------------------------------------------------------------#

#CREAMOS UN DICCIONARIO DONDE GUARDAREMOS LAS VARIABLES DE NIVEL

sensor_nivel_values={
    "tiempo_la":"2022-05-25 19:00:00",
    "niv_lamagua":"600",
    "niv_compadm":"150",
    "niv_compsal":"40",
    "detec_amax_comp1":"False",
    "detec_ctol_comp1":"True",
    "detec_amax_comp2":"False",
    "detec_ctol_comp2":"True",
    "pos_comp1":"800",
    "pos_comp2":"650",
    "niv_compadm_ext":"270",
    "niv_compadm_cau":"400",
    "niv_compsal_cau":"250"
}

#------------------------------------------------------------------#
#                        VARIABLES AMBIENTALES                     #
#------------------------------------------------------------------#

#CREAMOS UN DICCIONARIO DONDE GUARDAREMOS LAS VARIABLES AMBIENTALES
sensor_amb_values={
    "tiempo_amb":"2022-05-25 19:00:00",
    "precipitacion":"30",
    "rad_solar":"35",
    "hum_aire":"40",
    "temp_aire":"45",
    "vel_viento":"50",
    "pres_atm":"55",
    "temp_suelo":"60",
    "hum_suelo":"65"
}

def interpreta_trama(tramaRx):
    global gprs, bandera_muestreo, modemwifi, CONNECTION_MODE
    global banderaConsumo, banderaNivel, banderaAmb
    global trama
    try:
        if(tramaRx[0] == "b'T"):
           print("Llegaron variables Temporales")
           stamp = ntptime.time()
           stamplocal = stamp - 18000
           anio, mes, dia, hora, minn, seg, dsemana, dannio = localtime(stamplocal)
           
           anio = str(anio)
           dia  = '{0:02d}'.format(dia)
           mes  = '{0:02d}'.format(mes)
           hora = '{0:02d}'.format(hora)
           minn = '{0:02d}'.format(minn)
           seg  = '{0:02d}'.format(seg)

           valorTemporal = anio+'-'+mes+'-'+dia+' '+hora+':'+minn+':'+seg

           sensor_amb_values['tiempo_amb']    = valorTemporal
           sensor_consumo_values["tiempo_ele"]= valorTemporal
           sensor_nivel_values["tiempo_la"]   = valorTemporal

        elif (tramaRx[0] == "b'A"):

            print("Llegaron variables Ambientales")
            rad_solar = tramaRx[1]
            fc28      = tramaRx[2]
            dht22_tmp = tramaRx[3]
            dht22_hum = tramaRx[4]
            ds18b     = tramaRx[5]
            anemo     = tramaRx[6]
            pluvi     = tramaRx[7]
            bmp       = tramaRx[8]

            rad_solar = float(rad_solar)
            fc28      = float(fc28)
            dht22_tmp = float(dht22_tmp)
            dht22_hum = float(dht22_hum)
            ds18b     = float(ds18b)
            anemo     = float(anemo)
            pluvi     = float(pluvi)
            bmp       = float(bmp)

            rad_solar = '{0:.2f}'.format(rad_solar)
            fc28      = '{0:.2f}'.format(fc28)
            dht22_tmp = '{0:.2f}'.format(dht22_tmp)
            dht22_hum = '{0:.2f}'.format(dht22_hum)
            ds18b     = '{0:.2f}'.format(ds18b)
            anemo     = '{0:.2f}'.format(anemo)
            pluvi     = '{0:.2f}'.format(pluvi)
            bmp       = '{0:.2f}'.format(bmp)



            sensor_amb_values['precipitacion']=str(pluvi)
            sensor_amb_values['rad_solar']    =str(rad_solar)
            sensor_amb_values['hum_aire']     =str(dht22_hum)
            sensor_amb_values['temp_aire']    =str(dht22_tmp)
            sensor_amb_values['vel_viento']   =str(anemo)
            sensor_amb_values['pres_atm']     =str(bmp)
            sensor_amb_values['temp_suelo']   =str(ds18b)
            sensor_amb_values['hum_suelo']    =str(fc28)

            banderaAmb=1
        #             print(f'dht22_tmp: {dht22_tmp}')
        #             print(f'ds18b: {ds18b}')
        #             print(f'anemo: {anemo}')
        #             print(f'pluvi: {pluvi}')
        #             print(f'bmp: {bmp}')
        #             print("------------------------")
        #             print(" ")

        elif (tramaRx[0] == "b'C"):
            print("Llegaron variables de Consumo")
            Vcarga1   = tramaRx[1]
            Icarga1   = tramaRx[2]
            Carga1    = tramaRx[3]
            Iconsumo1 = tramaRx[4]
            Consumo1  = tramaRx[5]

            Vcarga1   = float(Vcarga1)
            Icarga1   = float(Icarga1)
            Carga1    = float(Carga1)
            Iconsumo1 = float(Iconsumo1)
            Consumo1  = float(Consumo1)

            Vcarga1   = '{0:.2f}'.format(Vcarga1)
            Icarga1   = '{0:.2f}'.format(Icarga1)
            Carga1    = '{0:.2f}'.format(Carga1)
            Iconsumo1 = '{0:.2f}'.format(Iconsumo1)
            Consumo1  = '{0:.2f}'.format(Consumo1)

            sensor_consumo_values['vdc_bat_comp1']   = Vcarga1
            sensor_consumo_values['idc_bat_comp1']   = Icarga1
            sensor_consumo_values['cbat_comp1']      = Carga1
            sensor_consumo_values['idc_siscomp1']    = Iconsumo1
            sensor_consumo_values['valcon_siscomp1'] = Consumo1

            banderaConsumo=1


        elif(tramaRx[0] == "b'N"):
             print("Llegaron variables Nivel")
             nivel_lamagua     = tramaRx[1]
             nivel_compadm     = tramaRx[2]
             nivel_compsal     = tramaRx[3]
             amax_comp1        = tramaRx[4]
             ctol_comp1        = tramaRx[5]
             amax_comp2        = tramaRx[6]
             ctol_comp2        = tramaRx[7]
             posComp1          = tramaRx[8]
             posComp2          = tramaRx[9]
             nivel_compadm_ext = tramaRx[10]
             nivel_compadm_cau = tramaRx[11]
             nivel_compsal_cau = tramaRx[12]

             nivel_lamagua     = float(nivel_lamagua)
             nivel_compadm     = float(nivel_compadm)
             nivel_compsal     = float(nivel_compsal)

             posComp1          = float(posComp1)
             posComp2          = float(posComp2)
             nivel_compadm_ext = float(nivel_compadm_ext)
             nivel_compadm_cau = float(nivel_compadm_cau)
             nivel_compsal_cau = float(nivel_compsal_cau)

             if amax_comp1 == '1':
                 amax_com1='True'
             else:
                 amax_comp1 = 'False'

             if ctol_comp1 == '1':
                 ctol_comp1='True'
             else:
                 ctol_comp1 = 'False'

             if amax_comp2 == '1':
                 amax_comp2='True'
             else:
                 amax_comp2 = 'False'

             if ctol_comp2 == '1':
                 ctol_comp2='True'
             else:
                 ctol_comp2 = 'False'

             nivel_lamagua     = '{0:.2f}'.format(nivel_lamagua)
             nivel_compadm     = '{0:.2f}'.format(nivel_compadm)
             nivel_compsal     = '{0:.2f}'.format(nivel_compsal)

             posComp1          = '{0:.2f}'.format(posComp1)
             posComp2          = '{0:.2f}'.format(posComp2)
             nivel_compadm_ext = '{0:.2f}'.format(nivel_compadm_ext)
             nivel_compadm_cau = '{0:.2f}'.format(nivel_compadm_cau)
             nivel_compsal_cau = '{0:.2f}'.format(nivel_compsal_cau)


             sensor_nivel_values['niv_lamagua']      = nivel_lamagua
             sensor_nivel_values['niv_compadm']      = nivel_compadm
             sensor_nivel_values['niv_compsal']      = nivel_compsal
             sensor_nivel_values['detec_amax_comp1'] = amax_comp1
             sensor_nivel_values['detec_ctol_comp1'] = ctol_comp1
             sensor_nivel_values['detec_amax_comp2'] = amax_comp2
             sensor_nivel_values['detec_ctol_comp2'] = ctol_comp2
             sensor_nivel_values['pos_comp1']        = posComp1
             sensor_nivel_values['pos_comp2']        = posComp2
             sensor_nivel_values['niv_compadm_ext']  = nivel_compadm_ext
             sensor_nivel_values['niv_compadm_cau']  = nivel_compadm_cau
             sensor_nivel_values['niv_compsal_cau']  = nivel_compsal_cau

             banderaNivel=1
            
        elif(tramaRx[0] == "b'G"):
            print("Reenviando datos al ATMEGA2560")
            uart.write(trama)
    except Exception as e:
        print("Error recibiendo trama de arduino", e)
        print("Se solicitan nuevamente datos")
        return 1
    
    if (tramaRx[0] == "b'E"):
        if CONNECTION_MODE == "WIFI":
            enviarWifi()
        elif CONNECTION_MODE == "GPRS":
            enviarGprs()

    tramaRx = " "
    bandera_muestreo = True
    return 0

def enviarGprs():
    global gprs, bandera_muestreo, CONNECTION_MODE
    global banderaConsumo, banderaNivel, banderaAmb
    global consumoIF, nivelIF, ambIF, reiniciarGPRSIF
    global trama

    tiempo_envio_gprs=3
    tipo_error=0

    consumoIF, nivelIF, ambIF, reiniciarGPRSIF = 0,0,0,0

    if banderaAmb == 1:

#         try:
#             gprs.post_var_ambientales(sensor_amb_values,'AWS')
#         except:
#             print('Error al Enviar Var AMB con el SERVIDOR: AWS')
#             ambIF=1


        sleep(tiempo_envio_gprs)
        try:
            gprs.post_var_ambientales(sensor_amb_values,'THOMASA')
        except:
            print('Error al Enviar Var AMB con el SERVIDOR: THOMASA')
            ambIF=1

        sleep(tiempo_envio_gprs)
        banderaAmb=0


    if banderaConsumo == 1:
#         try:
#             gprs.post_var_consumo(sensor_consumo_values,'AWS')
#         except:
#             print('Error al Enviar VAR. CONSUMO con el SERVIDOR: AWS')
#             consumoIF = 1


        sleep(tiempo_envio_gprs)

        try:
            gprs.post_var_consumo(sensor_consumo_values,'THOMASA')
        except:
            print('Error al Enviar VAR. CONSUMO con el SERVIDOR: THOMASA')
            consumoIF=1

        banderaConsumo=0
        sleep(tiempo_envio_gprs)

    if banderaNivel == 1:
#         try:
#             gprs.post_var_nivel(sensor_nivel_values,'AWS')
#         except:
#             print('Error al Enviar VAR. NIVEL con el SERVIDOR: AWS')
#             nivelIF=1


        sleep(tiempo_envio_gprs)

        try:
            gprs.post_var_nivel(sensor_nivel_values,'THOMASA')
        except:
            print('Error al Enviar VAR. NIVEL con el SERVIDOR: THOMASA')
            nivelIF=1


        banderaNivel=0
        sleep(tiempo_envio_gprs)

    if nivelIF == 1 or consumoIF == 1 or ambIF == 1:
        reiniciarGPRSIF=1

    return tipo_error

def enviarWifi():
    global gprs, bandera_muestreo, modemwifi, CONNECTION_MODE
    global banderaConsumo, banderaNivel, banderaAmb
    errorenv = 0
    if banderaAmb == 1:
        try:
            modemwifi.post_var_ambientales(sensor_amb_values,"THOMASA1")
        except:
            errorenv = 1
        try:
            modemwifi.post_var_ambientales(sensor_amb_values,"THOMASA2")
        except:
            errorenv = 1
        try:
            modemwifi.post_var_ambientales(sensor_amb_values,"LINDA")
        except:
            errorenv = 1
        #modemwifi.post_var_ambientales(sensor_amb_values,"AWS")
        #banderaAmb=0

    if banderaConsumo == 1:
        try:
            modemwifi.post_var_consumo(sensor_consumo_values,"THOMASA1")
        except:
            errorenv = 1
        try:
            modemwifi.post_var_consumo(sensor_consumo_values,"THOMASA2")
        except:
            errorenv = 1
        try:
            modemwifi.post_var_consumo(sensor_consumo_values,"LINDA")
        except Exception as e:
            errorenv = 1
            print(e)
        #modemwifi.post_var_consumo(sensor_consumo_values,"AWS")
        #banderaConsumo=0

        if banderaNivel == 1:
            modemwifi.post_var_nivel(sensor_nivel_values,"THOMASA1")
            modemwifi.post_var_nivel(sensor_nivel_values,"THOMASA2")
            modemwifi.post_var_nivel(sensor_nivel_values,"LINDA")
            #modemwifi.post_var_nivel(sensor_nivel_values,"AWS")
            #banderaNivel=0
            
        if banderaAmb == 1:
            banderaAmb=0
            #modemwifi.post_var_ambientales(sensor_amb_values,"THOMASA")

        if banderaConsumo == 1:
            banderaConsumo=0
            #modemwifi.post_var_consumo(sensor_consumo_values,"THOMASA")

        if banderaNivel == 1:
            banderaNivel=0
            #modemwifi.post_var_nivel(sensor_nivel_values,"THOMASA")
    if errorenv == 1:
        print('Error en la comunicacion enviar')
        return 1
    return 0


def sta_connection(connectionMode):
    global  SSID, PASSWORD
    global modemwifi, gprs

    if connectionMode == "GPRS":
        print("CONECTADO POR GPRS")
        condiciones_red = True
        while condiciones_red:
            intentos = 20
            try:
                gprs=system_gprs()
                gprs.config()
                gprs.initialize()
                condiciones_red = False
            except:
                print("Error al tratar de conectar a la red")
                condiciones_red = True
                
            if condiciones_red == True:
                for i in range(intentos,1,-1):
                    print("Esperando "+str(i)+" segundos para volver a intentar")
                    sleep(1)
                intentos = 20
                
        print("EL SISTEMA CONECTO CORRECTAMENTE AL GPRS")
        sleep(2)

    elif connectionMode == "WIFI":
        print("CONECTADO POR WIFI A LA RED ")
        print("SSID: "+SSID);
        condiciones_red = True

        while condiciones_red:
            intentos = 5
            try:
                modemwifi = system_wifi(SSID,PASSWORD)
                condiciones_red = False
            except:
                print("ERROR AL CONECTARSE A LA RED CON SSID: "+ SSID)

                condiciones_red = True
            if condiciones_red == True:
                for i in range(intentos,1,-1):
                    print("Esperando "+str(i)+" segundos para volver a intentar")
                    sleep(1)
                intentos = 5
        print("EL SISTEMA CONECTO CORRECTAMENTE A LA RED SSID: "+SSID)
        sleep(2)
        try:
            ntptime.settime()
            print("Hora ", localtime())
        except Exception as e:
            print("error NTP ", e)

def getDatosServer(server):
    global gprs, bandera_muestreo, modemwifi, CONNECTION_MODE

    if CONNECTION_MODE  == "WIFI":
        try:
            value = modemwifi.get_web(server)
        except:
            print("Error obteniendo datos del servidor "+server)
            return "error"
    else:
        try:
            code, value = gprs.get_web(server)
        except:
            print("Error obteniendo datos del servidor "+server)
            return "error"
        sleep(1)
    return value

def get_ServerVALUES():
    global trama
    global textoCompuerta,textoLamina, textoMuestreo, textoHora, t_envio, contador_envio
    global reiniciarGPRSIF
    print("Obteniendo Datos del servidor  ")

    textoCompuerta = getDatosServer("COMPUERTA")
    textoLamina    = getDatosServer("LAMINA")
    textoMuestreo  = getDatosServer("MUESTREO")
    textoHora      = getDatosServer("HORA")


    print('INFO COMPUERTA: '+ textoCompuerta)
    print('INFO LAMINA: '+textoLamina)
    print('INFO MUESTREO: '+textoMuestreo)
    print('INFO HORA: '+textoHora)
    
    condicion1 = "error" in textoCompuerta or "error" in textoLamina or "error" in textoMuestreo or "error" in textoHora
    condicion2 = textoCompuerta=='' or textoLamina=='' or textoMuestreo=='' or textoHora==''
    
    if  condicion1 or condicion2:
        reiniciarGPRSIF=1
        print("Error en la Recepcion de datos")
    else:
        #Guardamos en un arreglo los valoes que llegan del JSON del servidor
        arregloCompuerta = textoCompuerta.split(",")
        print(arregloCompuerta)
        print(arregloCompuerta[0])
        print(arregloCompuerta[1])
        print(arregloCompuerta[2])

        dic_compuerta_adm   = arregloCompuerta[0].split(":")
        dic_compuerta_sal   = arregloCompuerta[1].split(":")
        dic_estado_estacion = arregloCompuerta[2].split(":")

        compuerta_adm   = dic_compuerta_adm[1]
        compuerta_sal   = dic_compuerta_sal[1]
        estado_estacion = dic_estado_estacion[1]

        compuerta_adm   = compuerta_adm.replace('"',' ')
        compuerta_sal   = compuerta_sal.replace('"',' ')
        estado_estacion = estado_estacion.replace("}"," ")

        print("-------------------------------")
        print("Informacion Compuertas")
        print("-------------------------------")
        print(compuerta_adm)
        print("adm: "+compuerta_adm)
        print("-------------------------------")
        print("-------------------------------")
        print(compuerta_sal)
        print("adm: "+compuerta_sal)
        print("-------------------------------")
        print("-------------------------------")
        print(estado_estacion)
        print("adm: "+estado_estacion)
        print("-------------------------------")


        pos_admi = int(compuerta_adm)
        pos_sal  = int(compuerta_sal)
        
        print("prueba estado estacion: "+estado_estacion)
        
        if  "f" in estado_estacion:
            state   = '0'
        elif "t" in estado_estacion :
            state = '1'
        
        t_envio = int(textoMuestreo)

        fecha = textoHora[0:11]
        hora  = textoHora[12:20]

        hora = hora.replace(":","/")
        setPoint=textoLamina

        trama = "V/"+str(pos_admi)+"/"+str(pos_sal)+"/"+state+"/"+str(t_envio)+"/"+fecha+"/"+hora+"/"+setPoint+"/#"
        uart.write(trama)
        print(trama)
        print("Compuerta ADMIN:  "+ str(pos_admi))
        print("Compuerta SALIDA: "+ str(pos_sal))
        print("Estado Operativo: "+ state )

        print("SP LAMINA: " + setPoint)
        print("TIEMPO ENVIO: " + str(t_envio))
        print("FECHA SERVER : " + fecha)
        print("HORA SERVER : " + hora)

    

def run():
    global recibiendoDATOS, tiempoSONDEOWEB
    global tramaRx, sensor_amb_values, gprs, bandera_muestreo, sensor_consumo_values, sensor_nivel_values
    global CONNECTION_MODE
    global modemwifi
    global textoCompuerta,textoLamina, textoMuestreo, textoHora, t_envio, contador_envio
    global banderaConsumo, banderaNivel, banderaAmb
    global consumoIF, nivelIF, ambIF, reiniciarGPRSIF

    tiempoSONDEOWEB = TIAMPO_SONDEO_CONST
    recibiendoDATOS = True
    banderaConsumo, banderaNivel, banderaAmb, reiniciarGPRSIF = 0,0,0,0

    contador_envio = 30
    contador_reinicio = 1800

    bandera_muestreo = True
    uart.init(9600, bits=8, parity=None, stop=1, tx=18, rx=19)

    sta_connection(CONNECTION_MODE)

    consumoIF, nivelIF, ambIF, reiniciarGPRSIF = 0,0,0,0

    print('------------------------------------------------------')
    print('              PROGRAMA PRINCIPAL                      ')
    print('------------------------------------------------------')
    
#    get_ServerVALUES()

    while(True):

        if  not(recibiendoDATOS):
            tiempoSONDEOWEB -= 1
            if tiempoSONDEOWEB == 0:
                #pedir datos al servidor
                #get_ServerVALUES()
                tiempoSONDEOWEB = TIAMPO_SONDEO_CONST



        if reiniciarGPRSIF==1 and CONNECTION_MODE == "GPRS":
            print("Se reestablece la comunicacion GPRS")
            
            gprs.restartGPRS()
            sta_connection(CONNECTION_MODE)
            reiniciarGPRSIF = 0
            #Volver a solicitar datos al servidor
            contador_envio = 30

        if bandera_muestreo:
            print(sensor_amb_values)
            bandera_muestreo = False

        if ( uart.any() > 0 ):
            recibiendoDATOS = True
            aux = uart.readline()
            buffer = str(aux)
            tramaRx = buffer.split('/')
            print("----------------------------");
            print("      Trama Recibida        ");
            print(tramaRx)
            print("----------------------------");
            status_Rx = interpreta_trama(tramaRx)
            if status_Rx == 1:
                uart.write("S/1/#")
            
            recibiendoDATOS = False

            #Solicitar la informacion de los METODOS GEt
        '''
        status_gprs=gprs.get_StatusRed()
        
        if status_gprs == 1:
            sta_connection(CONNECTION_MODE)
        '''
        
        sleep(1)
        contador_reinicio -= 1
        
        if contador_reinicio > 0:
          wdt.feed()
          pass
        
#         contador_envio -= 1  
#         if contador_envio == 0:
#             contador_envio = 120
#             get_ServerVALUES()




if __name__=='__main__':
    run()
