TsunaHalo2001/RECUV/RECUV 2/Arduino Mega 2560/main/main.ino

#include "config.h"


void setup() {
  Serial.begin(9600);
  wdt_disable();
  // put your setup code here, to run once:
  //Se inicializa el metodo de presion atmosferica
  estacion.bmp180begin();

  //Se inicializa el metodo de humedad del aire
  estacion.dhtbegin();

  //Se inicializa el metodo de temperatura del suelo
  estacion.ds18b20begin();

  //Se inicializa el reloj en tiempo real

  //Se inicializa la interrupcion del anemometro
  attachInterrupt(digitalPinToInterrupt(windPulsePin), windCounterInterrupt, FALLING);

  //Se inicializa la interrupcion del pluviometro
  attachInterrupt(digitalPinToInterrupt(rainPulsePin), rainCounterInterrupt, FALLING);

  estacion.actTiempo();

  wdt_enable(WDTO_8S); //WATCHDOG HABILITACIÓN
}

void loop() {
  // put your main code here, to run repeatedly:
  
  if (estacion.recibiendo()) {}
  else {
    //Valor alerta de precipitacion
    if(estacion.cont_A >= 12) {
       estacion.cont_A = 0;
       if((estacion.getpreci_actual() - estacion.getpreci_min()) > valor_Alerta) estacion.cont_E = 1;
       else estacion.setpreci_min(estacion.getpreci_actual());
       if((estacion.getpreci_actual1() - estacion.getpreci_min1()) > 0.1) estacion.cont_E = 1;
       else estacion.setpreci_min1(estacion.getpreci_actual1());
       if((estacion.getpreci_actual2() - estacion.getpreci_min2()) > 0.1) estacion.cont_E = 1;
       else estacion.setpreci_min2(estacion.getpreci_actual2());
    }

    if(estacion.cont_M > tMuestreo) {
      estacion.actTiempo();
      estacion.actualizarAmbiental();
      estacion.actualizarEnergia();
      estacion.cont_A++;
      estacion.cont_M = 0;
    }

    if(estacion.cont_E == 1 || estacion.geterrorrecibo() == 1) {
      estacion.enviarTodo();
      estacion.comunicador.errorrecibo = 0;
      estacion.cont_E = 0;
      estacion.eenable = false;
    }
  	
    if(estacion.getmin() % 10== 0 && estacion.eenable) {
      estacion.cont_E = 1;
    }

    if(estacion.getmin() % 5== 0) {
      estacion.eenable = true;
    }

    if(estacion.cont_E % 100 == 0) estacion.comunicador.mostrarTrama();
    delay(100);

    estacion.contarTiempo();

    estacion.reciboEsp();
    estacion.reciboArd();

    estacion.actTiempo();
  }
  wdt_reset();
}
