TsunaHalo2001/RECUV/RECUV 3/Arduino Mega 2560/main/Interrupciones.ino

void serialEvent1() {
  estacion.comunicador.serialEvent1();
}

void windCounterInterrupt() {
  estacion.comunicador.ambiental.windCounterInterrupt();
}

void rainCounterInterrupt() {
  estacion.comunicador.ambiental.rainCounterInterrupt();
}

void rainCounterInterrupt1() {
  estacion.comunicador.trampa.rainCounterInterrupt1();
}

void rainCounterInterrupt2() {
  estacion.comunicador.trampa.rainCounterInterrupt2();
}
