TsunaHalo2001/RECUV/RECUV Niebla/Arduino Mega 2560/main/Estacion.h

#include <Arduino.h>
#include <stdint.h>

#include "Comunicador.h"

class Estacion {
  public:
    Comunicador comunicador;

    long int cont_E;
    long int cont_M;

    Estacion(Comunicador);
    ~Estacion();
    bool recibiendo();
    void contarTiempo();

    void celdabegin1(uint8_t, uint8_t, long, float);
    void celdabegin2(uint8_t, uint8_t, long, float);
    void irbegin();

    long int gettEnvio();
    int geterrorenvio();
    void actTrampa();
    void enviarTodo();
    void reciboRX();

  
};
