TsunaHalo2001/RECUV/RECUV 1/Arduino Mega 2560/main/Comunicador.h

#include <Arduino.h>
#include <stdint.h>

#include "Tiempo.h"
#include "Ambiental.h"
#include "Energia.h"

char *strtok(char *str1, const char *str2);

class Comunicador {
  public:
    String buffer_tx;

    Tiempo tiempo;
    Ambiental ambiental;
    Energia energia;

    long int tEnvio;

    int banderaL;
    int banderaL2;
    int banderaL3;
    char banderaESPRx;
    char banderaESPRx3;
    char indiceESPRX;
    int contadorseparador;
    char contadorFRAMEESPRX;
    char ESPString[100];
    int errorrecibo;

    char *ptr = NULL;

    Comunicador(Tiempo, Ambiental, Energia);
    ~Comunicador();
    //Envio
    void enviarTiempo();
    void enviarAmbiental();
    void enviarEnergia();
    void enviarTodo();

    //Recepcion
    void serialEvent1();
    void reciboEsp();
};
