TsunaHalo2001/RECUV/(commit log)

2024-07-18 added docs
    [Calculos RECUV 2.xlsx]
2024-07-26 simplified RECUV2 ESP32, added upy version
2024-07-31 added bmp180 i2c to esp32 and corrected code
    [Comunicador.cpp, Trampa.cpp, Trampa.h, config.h, main.ino, main.py, system_communication.py]
2024-08-01 corrected esp, added visual on trama
    [Comunicador.cpp, Comunicador.h, Potencia.cpp, main.ino, main.py]
2025-02-10 Añadida rutina para reiniciar la ESP32 con intervalos regulares para evitar la detencion del programa
2025-05-16 PCB files
    [RECUV01.kicad_pcb, RECUV01.kicad_sch]
2025-07-05 Update maintenance guide with detailed steps for BMP180 and ESP32 connections, and add instructions for adding new data server addresses.
2025-07-10 Add initial Gerber job file for RECUV01 PCB design
    - Created RECUV01-job.gbrjob file with project specifications
    - Included header information with generation software details
    - Defined general specifications such as project ID, size, layer number, and board thickness
    - Specified design rules for pad and track spacing
    - Listed file attributes for copper layers, solder paste, silkscreen, solder mask, and edge cuts
    - Documented material stackup including types and thicknesses for each layer
    [RECUV01-B_Cu.gbr, RECUV01-B_Mask.gbr, RECUV01-B_Paste.gbr, RECUV01-B_Silkscreen.gbr, RECUV01-Edge_Cuts.gbr, RECUV01-F_Cu.gbr, RECUV01-F_Mask.gbr, RECUV01-F_Paste.gbr]
2026-01-13 Se corrigio TX y RX del CH340 en esquematico
    TODO:
    Corregirlo en PCB
    [RECUV01.csv, RECUV01.kicad_sch]
2026-01-22 TODO soil and communication
    [Conexiones.xlsx]
2026-01-23 TODO check wind interrupt, voltage and current
2026-01-28 added k18 network and corrected davis6450 measure (now in mW/m2 by accident)
    [DAVIS6450.cpp, Estacion.cpp]
2026-06-09 Added a New RECUV File
    - USB-C Added
    - UD+ and UD- etiquetes added
    - VBUS added
    [RECUV01.kicad_sch, RECUV02.kicad_pcb, RECUV02.kicad_sch, bom.csv, designators.csv, positions.csv]
2026-06-09 Added CC1 and CC2 resistor
    [RECUV02.kicad_sch]
2026-06-09 Reordered USB-C Module and Connections, finished USB-C
    [RECUV02.kicad_sch]
2026-06-09 Corrected USB-C Resistor
    [RECUV02.kicad_sch]
2026-06-09 Added values for Resistors and Capacitors
    [RECUV02.kicad_sch]
2026-06-09 Added UD+ and UD- on CH340
    [RECUV02.kicad_sch]
2026-06-09 Added RTS and DTR to CH340
    [RECUV02.kicad_sch]
2026-06-09 Added V3 and GND to CH340
    [RECUV02.kicad_sch]
2026-06-09 Added LED, TX and RX to CH340
    [RECUV02.kicad_sch]
2026-06-09 Corrected V3 PIN for CH340
    [RECUV02.kicad_sch]
2026-06-09 Added 3v3 to gnd capacitor for CH340
2026-06-09 Reorganized and changed 1k by 470 for led intensity
    [RECUV02.kicad_sch]
2026-06-09 Closed USB Connector secion
    [RECUV02.kicad_sch]
2026-06-09 corrected polygon
    [RECUV02.kicad_sch]
2026-06-09 Added VEXT Screw Terminal
    [RECUV02.kicad_sch]
2026-06-09 added Schottky connection
    [RECUV02.kicad_sch]
2026-06-09 Added A1117 and GND
    [RECUV02.kicad_sch]
2026-06-09 Finished Power Supply Section
    [RECUV02.kicad_sch]
2026-06-09 Finished Boot Settings
    [RECUV02.kicad_sch]
2026-06-09 Added ESP32S3 left row pins
    [RECUV02.kicad_sch]
2026-06-09 Added all PINs to ESP32S3
    [RECUV02.kicad_sch]
2026-06-09 Added CHIP_PU capacitor
    [RECUV02.kicad_sch]
2026-06-09 Finished Microcontroller section
    [RECUV02.kicad_sch]
2026-06-09 Added voltage divider
    [RECUV02.kicad_sch]
2026-06-09 Finished electrical sensors
    [RECUV02.kicad_sch]
2026-06-09 Finished Bus I2C
    [RECUV02.kicad_sch]
2026-06-09 Finished RJ11 sensors and corrected bus i2c bug
    [RECUV02.kicad_sch]
2026-06-09 Finished all PCB sections
    [RECUV02.kicad_sch]
2026-06-09 Finished PCB
    [RECUV02.kicad_pcb, RECUV02.kicad_sch]
2026-06-09 Corrected PCB Form
    [RECUV02.kicad_pcb]
2026-06-09 Corrected ESP32 Antenna
    [RECUV02.kicad_pcb]
2026-07-24 Add initial positions CSV and lock files for RECUV02 project
    - Created positions.csv with component designators, coordinates, and orientations for the PCB layout.
    - Added lock files (~RECUV02.kicad_pcb.lck and ~RECUV02.kicad_pro.lck) to track editing sessions.
    [RECUV02.kicad_pcb, RECUV02.kicad_sch, bom-JLCPCB Assembly Order.xls, bom.csv, designators.csv, positions.csv]
2026-07-25 Fix UTC URL in variables.json and update Reloj class to use startsWith for HTTPS check
    [Reloj.cpp]
2026-07-25 Fix UTC URL in variables.json and remove duplicate header in Reloj class HTTP request
    [Reloj.cpp]
2026-07-28 Add Trampa and Estacion classes for environmental data collection
    - Implemented Trampa class to handle rain and weight measurements using HX711 sensors.
    - Created Estacion class to manage data collection and communication with the Trampa class.
    - Added configuration settings in config.h for pin assignments and measurement parameters.
    - Introduced logging functionality for better debugging and monitoring of system status.
    - Developed main application logic in main.ino to initialize components and manage data flow.
    - Established serial communication for data transmission and reception.
    - Included necessary libraries and headers for functionality.
    [Conexiones.xlsx]
2026-07-28 Add lock file for RECUV01 PCB design
2026-07-30 Remove lock file for RECUV01 PCB design to prevent conflicts during collaborative editing.
    [SIM800LMANUAL.py, main.py, system_communication.py]
